neurotech-berkeley/emg-neurowrist/README.md

# emg-neurowrist
Building an EMG-wristband
