neurotech-berkeley/emg-neurowrist/basic_signal/README.md

### Basic Signal Acquisition Script

Run through Arduino IDE
- Use Board Config: ESP32 Dev Module
- Ensure that you have installed the CP201x USB to UART Bridge Driver
  - For Windows: https://www.reddit.com/r/esp32/comments/12ulriv/cp210x_usb_to_uart_bridge_in_windows_11/
