neurotech-berkeley/emg-neurowrist/KiCAD/analog-front-end/emg-analog-front-end.kicad_pcb

## KiCad design KiCAD/analog-front-end/emg-analog-front-end.kicad_pcb (2023-04-20)

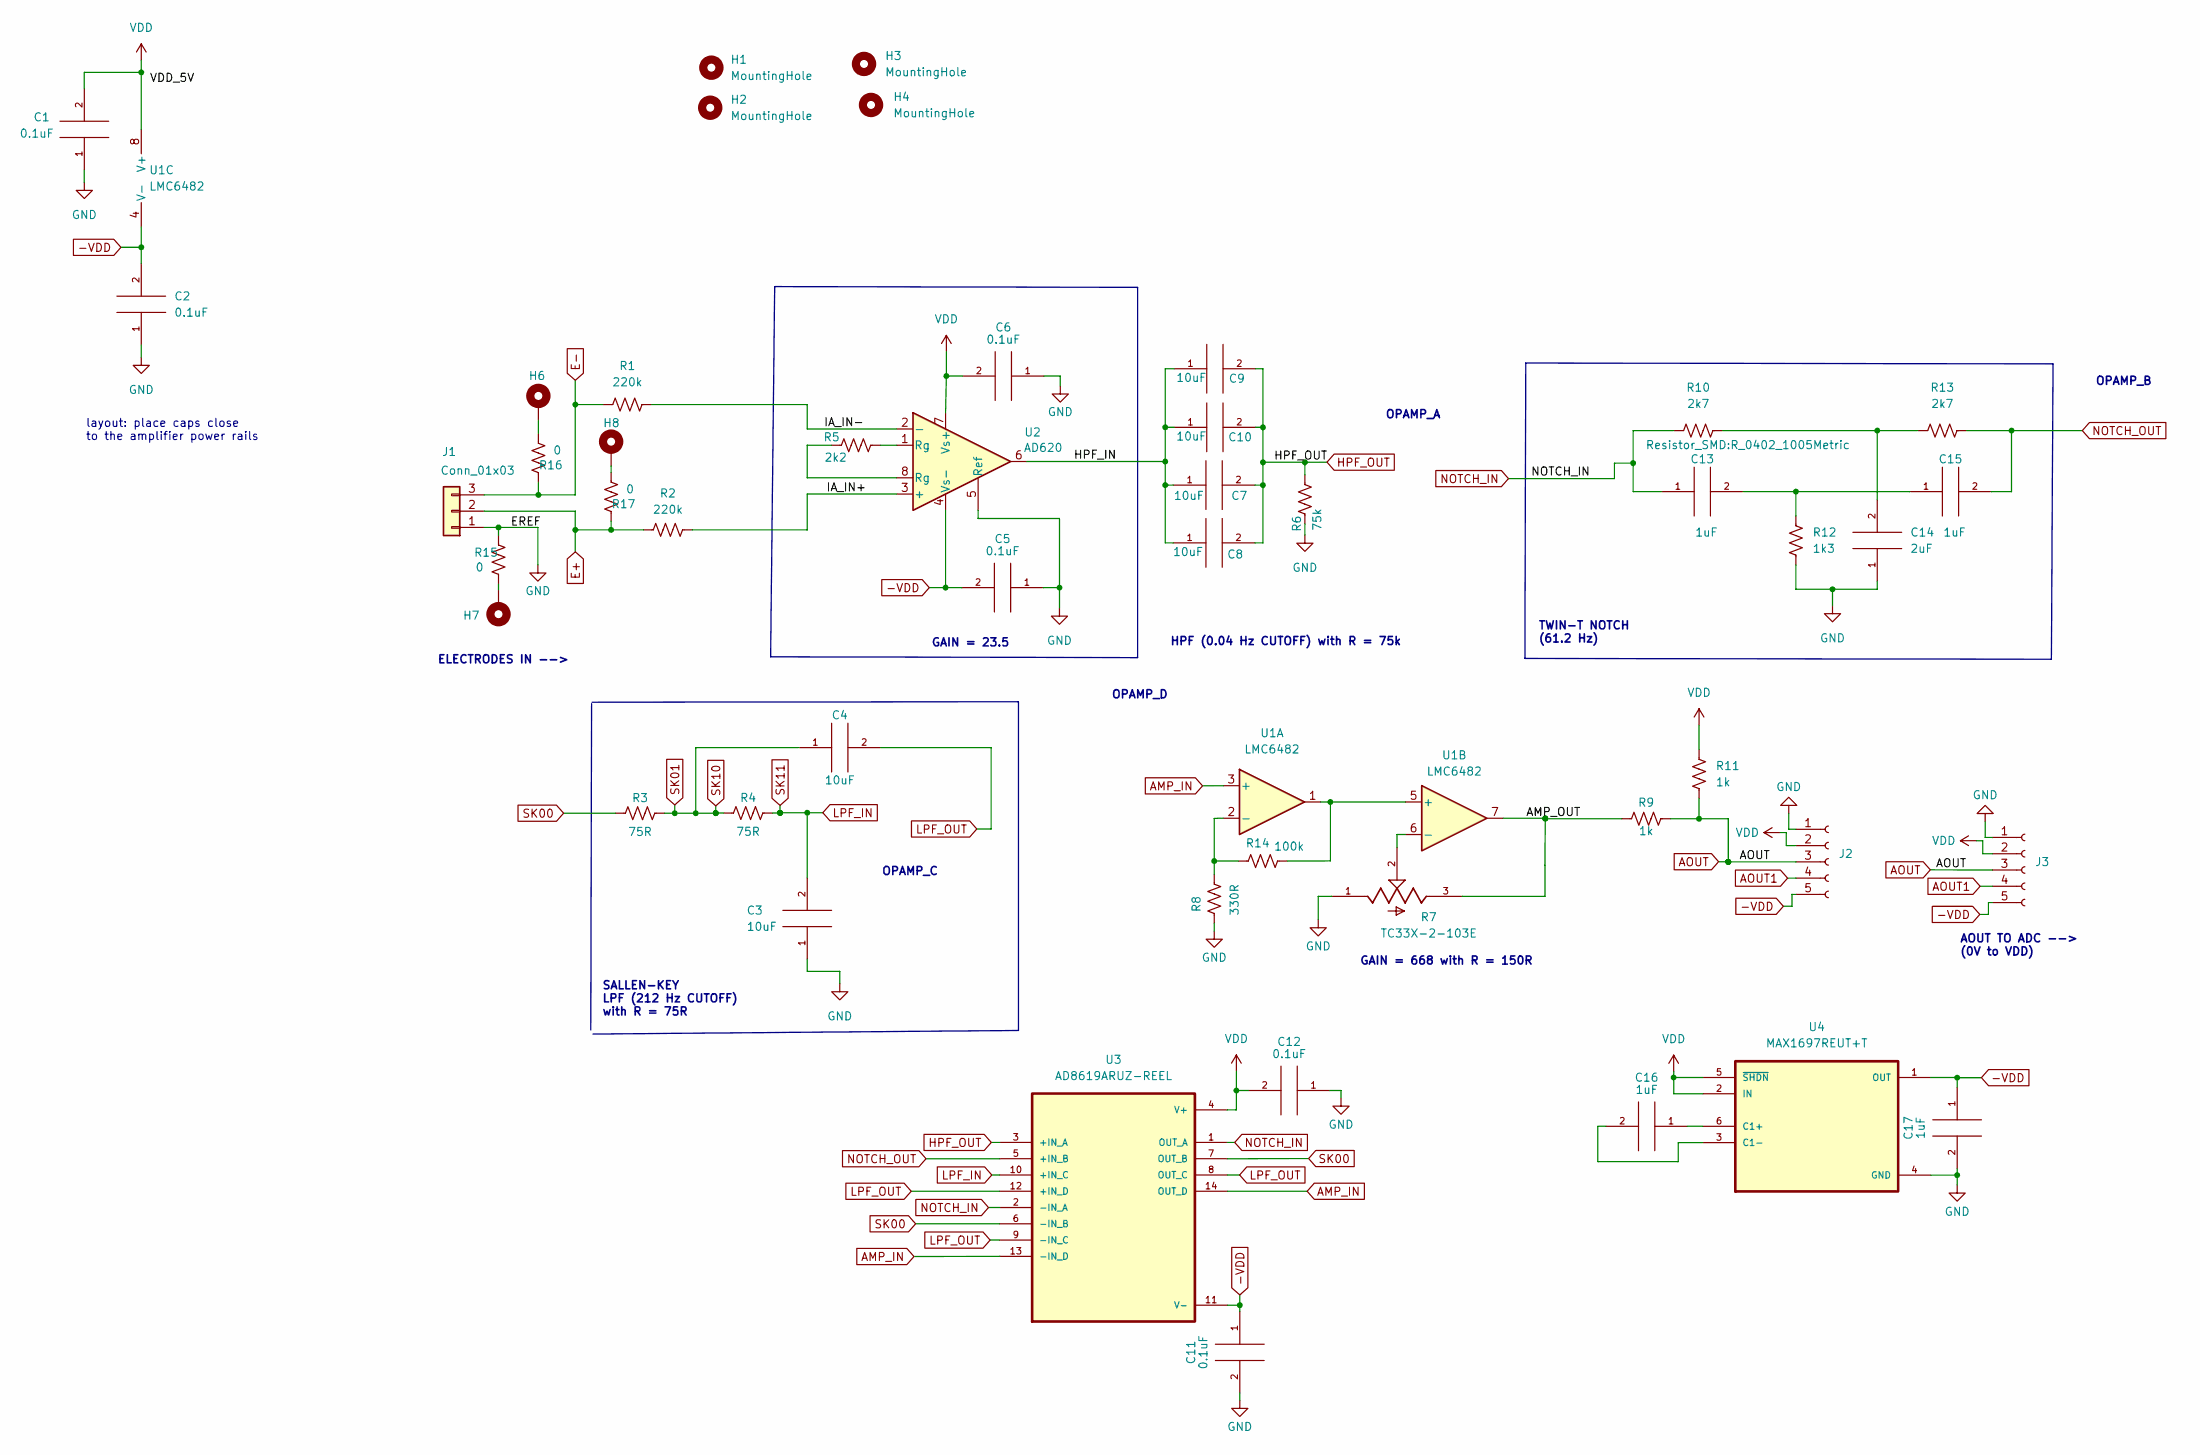
[picture p1: schematic emg-analog-front-end.kicad_sch]

Parts:
C1, C2, C5, C6, C11, C12: 0.1uF; C_0402_1005Metric
C3, C4, C7, C8, C9, C10: 10uF; C_0402_1005Metric
C13, C15, C16, C17: 1uF; C_0402_1005Metric
C14: 2uF; C_0402_1005Metric
H1, H2, H3, H4: MountingHole; MountingHole_2.2mm_M2
H6, H7, H8: MountingHole_Pad; MountingHole_2.2mm_M2_ISO7380_Pad
J1: Conn_01x03; PinHeader_1x03_P1.27mm_Vertical
J2, J3: Conn_01x05_Female; PinHeader_1x05_P1.27mm_Vertical
R1, R2: 220k; R_0402_1005Metric
R3, R4: 75R; R_0402_1005Metric
R5: 2k2; R_0603_1608Metric
R6: 75k; R_0603_1608Metric
R7: TC33X-2-103E; TRIM_TC33X-2-103E
R8: 330R; R_0402_1005Metric
R9, R11: 1k; R_0402_1005Metric
R10, R13: 2k7; R_0402_1005Metric
R12: 1k3; R_0402_1005Metric
R14: 100k; R_0402_1005Metric
R15, R16, R17: 0; R_0402_1005Metric
U1: LMC6482; SOIC-8_3.9x4.9mm_P1.27mm
U2: AD620; SOIC-8_3.9x4.9mm_P1.27mm
U3: AD8619ARUZ-REEL; SOP65P640X120-14N
U4: MAX1697REUT+T; SOT95P280X145-6N

Connections:
-VDD: C2.2, C5.2, C11.1, C17.1, J2.5, J3.5, U1.4 (V-), U2.4 (Vs-), U3.11 (V-), U4.1 (OUT)
/HPF_IN: C7.1, C8.1, C9.1, C10.1, U2.6
/IA_IN+: R2.2, U2.3 (+)
/IA_IN-: R1.2, U2.2 (-)
AMP_IN: U1.3 (+), U3.13 (-IN_D), U3.14 (OUT_D)
AOUT: J2.3, J3.3, R9.1, R11.1
AOUT1: J2.4, J3.4
E+: J1.2, R2.1, R17.2
E-: J1.3, R1.1, R16.2
GND: C1.1, C2.1, C3.1, C5.1, C6.1, C11.2, C12.1, C14.1, C17.2, J1.1, J2.1, J3.1, R6.2, R7.1, R8.1, R12.2, R15.2, U2.5 (Ref), U4.4 (GND)
HPF_OUT: C7.2, C8.2, C9.2, C10.2, R6.1, U3.3 (+IN_A)
LPF_IN: C3.2, R4.1, U3.10 (+IN_C)
LPF_OUT: C4.2, U3.8 (OUT_C), U3.9 (-IN_C), U3.12 (+IN_D)
NOTCH_IN: C13.1, R10.2, U3.1 (OUT_A), U3.2 (-IN_A)
NOTCH_OUT: C15.2, R13.1, U3.5 (+IN_B)
unnamed: C13.2, C15.1, R12.1
unnamed: C14.2, R10.1, R13.2
unnamed: C16.1, U4.6 (C1+)
unnamed: C16.2, U4.3 (C1-)
unnamed: H6.1, R16.1
unnamed: H7.1, R15.1
unnamed: H8.1, R17.1
unnamed: R5.1, U2.1 (Rg)
unnamed: R5.2, U2.8 (Rg)
unnamed: R7.2, U1.6 (-)
unnamed: R7.3, R9.2, U1.7
unnamed: R8.2, R14.1, U1.2 (-)
unnamed: R14.2, U1.1, U1.5 (+)
SK00: R3.2, U3.6 (-IN_B), U3.7 (OUT_B)
SK01: C4.1, R3.1, R4.2
VDD: C1.2, C6.2, C12.2, J2.2, J3.2, R11.2, U1.8 (V+), U2.7 (Vs+), U3.4 (V+), U4.2 (IN), U4.5 (~SHDN)

Notes on the sheet:
GAIN = 23.5
TWIN-T NOTCH (61.2 Hz)
OPAMP_C
OPAMP_B
OPAMP_D
layout: place caps close to the amplifier power rails
HPF (0.04 Hz CUTOFF) with R = 75k
GAIN = 668 with R = 150R
SALLEN-KEY LPF (212 Hz CUTOFF) with R = 75R
ELECTRODES IN -->
AOUT TO ADC --> (0V to VDD)
OPAMP_A

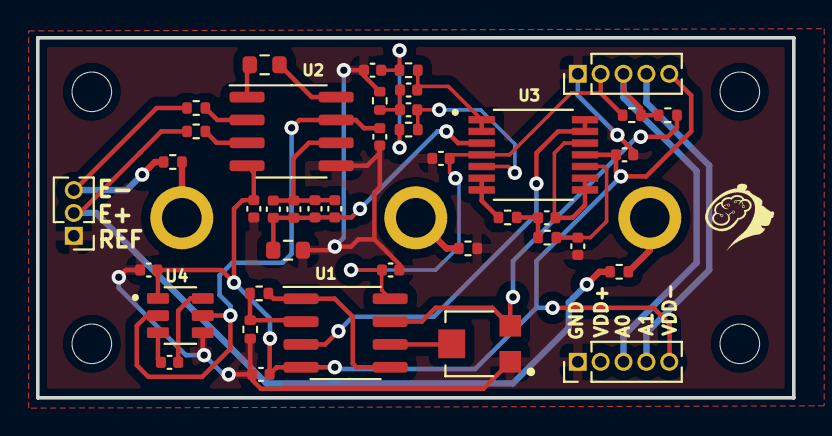
[picture p2: board emg-analog-front-end.kicad_pcb from above]

Board: 2 copper layers, 42.0 x 20.0 mm, 48 parts (0 on the bottom side), 31 nets.
