neurotech-berkeley/emg-neurowrist/KiCAD/voltage-regulator/emg-voltage-regulator.kicad_pcb

## KiCad design KiCAD/voltage-regulator/emg-voltage-regulator.kicad_pcb (2023-03-13)

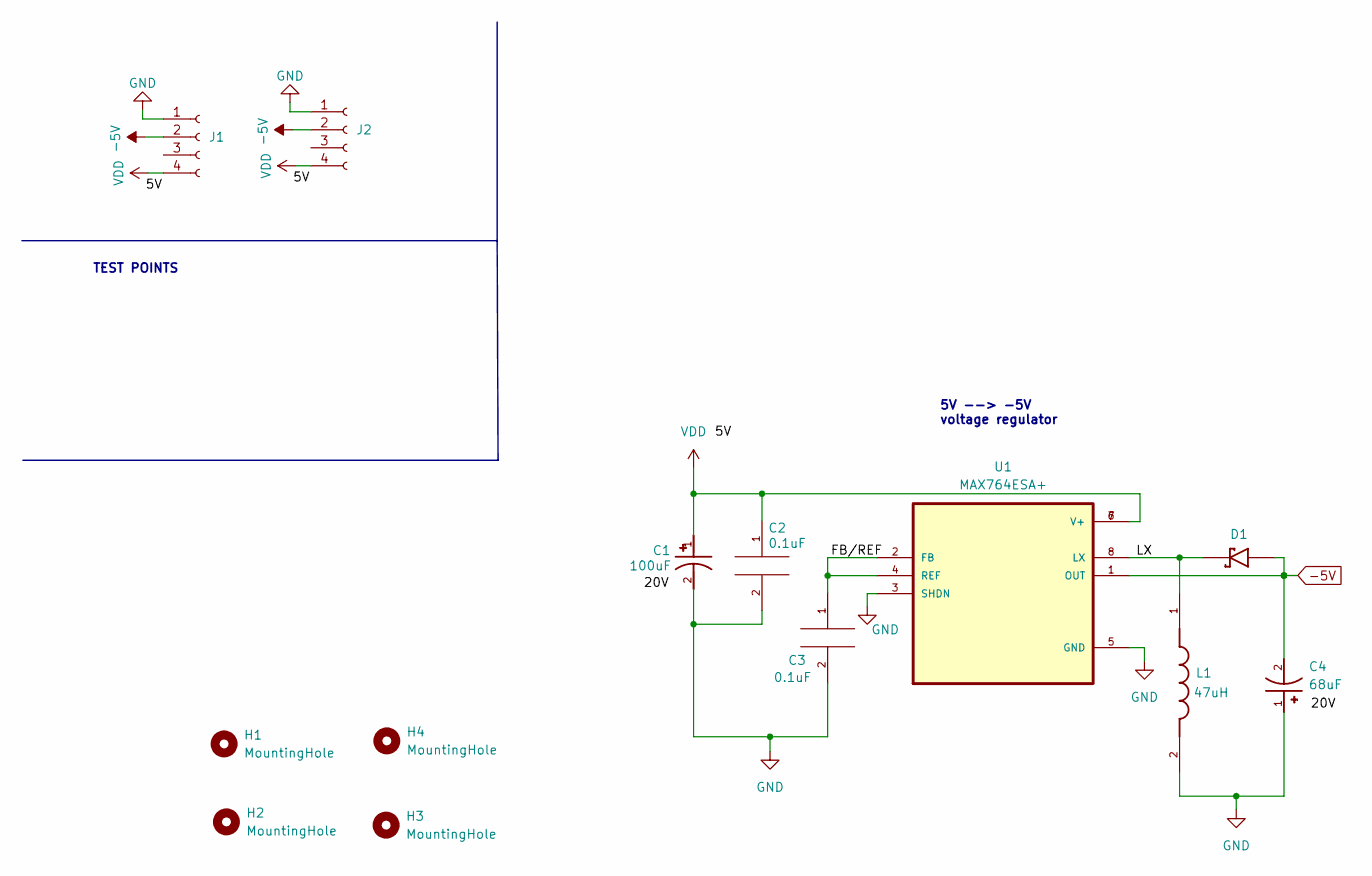
[picture p3: schematic emg-voltage-regulator.kicad_sch]

Parts:
C1: 100uF; CAP_20TQC100MYF; PARTREV 30-Nov-20
C2, C3: 0.1uF; C_0603_1608Metric
C4: 68uF; CAP_20TQC100MYF; PARTREV 30-Nov-20
D1: MBRS330T3G; DIOM7959X261N; PARTREV 14
H1, H2, H3, H4: MountingHole; MountingHole_2.2mm_M2
J1, J2: Conn_01x04_Female; PinHeader_1x04_P1.27mm_Vertical
L1: 47uH; IND_NRS6028T470M; PARTREV N/A
U1: MAX764ESA+; SOIC127P600X175-8N

Connections:
-5V: C4.2, D1.A, J1.2, J2.2, U1.1 (OUT)
/FB/REF: C3.1, U1.2 (FB), U1.4 (REF)
/LX: D1.C, L1.1, U1.8 (LX)
GND: C1.2, C2.2, C3.2, C4.1, J1.1, J2.1, L1.2, U1.3 (SHDN), U1.5 (GND)
VDD: C1.1, C2.1, J1.4, J2.4, U1.6 (V+), U1.7 (V+)

Notes on the sheet:
TEST POINTS
5V --> -5V voltage regulator

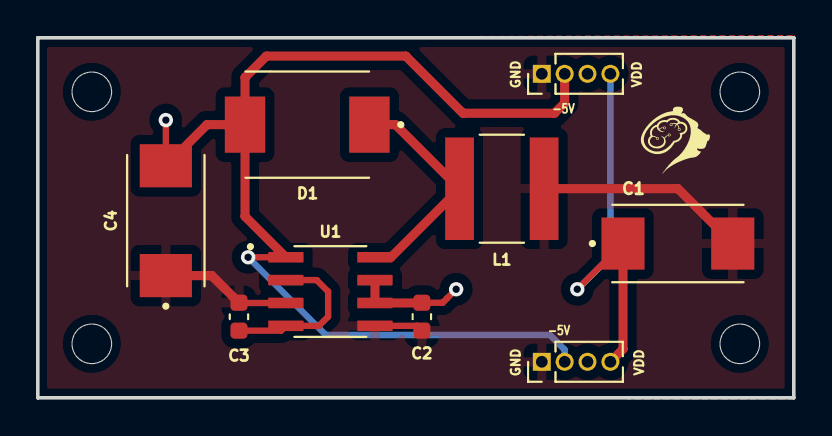
[picture p4: board emg-voltage-regulator.kicad_pcb from above]

Board: 2 copper layers, 42.0 x 20.0 mm, 13 parts (0 on the bottom side), 5 nets.
