neurotech-berkeley/emg-neurowrist/(commit log)

2023-03-12 making separate PCBs for analog front-ends
    [emg-analog-front-end.kicad_pcb, emg-analog-front-end.kicad_sch, emg-voltage-regulator.kicad_pcb, emg-voltage-regulator.kicad_sch]
2023-03-13 more progress on layout
    [emg-analog-front-end.kicad_pcb, emg-analog-front-end.kicad_sch]
2023-03-13 AFE sub-circuit layout done
    [emg-analog-front-end.kicad_pcb, emg-analog-front-end.kicad_sch]
2023-03-13 layout for voltage regulator done
    [emg-voltage-regulator.kicad_pcb, emg-voltage-regulator.kicad_sch]
2023-03-13 added VSS input to the AFE board
    [emg-analog-front-end.kicad_pcb, emg-analog-front-end.kicad_sch, emg-voltage-regulator.kicad_pcb]
2023-03-13 adding production files
    [BOM.csv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]
2023-03-22 small fixes, dimensions
    [emg-analog-front-end.kicad_pcb]
2023-03-27 automatic save to csv files should work
    [emg_data_20230327-160320.csv]
2023-04-18 modifying the pcb for new electrode placement and replacing op amps
    [emg_data_20230409-181434.csv]
2023-04-20 added mounting hole plates for electrodes and replaced op-amp and voltage regulator ICs
    [emg-analog-front-end.kicad_pcb, emg-analog-front-end.kicad_sch]
2023-04-20 adding fabrication files
    [BOM.csv, emg-analog-front-end BOM.csv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]
